cradle08/LLD_TMC/ReadMe.txt

LLD002_TMC5130_HAL：是液面探测TMC5130版本，裸机版本（采用HAL库，自己重新重构，已单独建库）
使用：MK文件下的工程

LLD002_TMC5130：是液面探测TMC5130版本，已该版本，采用rt-thread系统版本
使用：Project_debug文件下的工程

LLD001_FDC2212_DLVR_v3.0.0_TMC2209：添加了2209的驱动，没有算法
LLD002_TMC5130A - 20230410.rar：20230421美静发送过来的--需更新5130部分功能

/*************************液面探测驱动板*********************************/
STM32F103C8T6, 20k_RAM, 64_Flash

CAN:
    RX: PA11
    TX: PA12

UART:(链接TMC)
    UART_RX：PA10
    UART_TX：PA9

IIC1:(气压传感器)
    CLK:  PB6
    SDA: PB7

IIC2（电容传感器）:
    CLK:  PB10
    SDA: PB11

SYS_LED:
    PB4

SW1-4:
    PC13\PC14\PC15, PA7

NTC：
    PA3（ADC）

FDC2212: 
    ADD: PA1
    INTB: PA4
    SD: PA5

光耦：
P_DP1: PA15（复位光耦）
P_DP1: PB0（限位位光耦）

LLD液面探测反馈信号: 
    PB1

SPI2: (链接FLASH)
    SPI_MOSI: PB15
    SPI_MISO: PB14
    SPI_CLK: PB13
    SPI_CS: PB12

TMC5130:
    SPI_MOSI: PB15
    SPI_MISO: PB14
    SPI_CLK: PB13
    SPI_CS: PB3

TMC2209:
    SPREAD: PB3
    DIR: PB4
    EN: PA6
    STEP:PB5
    CLK:PA8
