cradle08/LLD_TMC/Doc/液面探测/CPLLD模块CAN通讯协议V1.0.0_20220525.docx

CPLLD模块Can通讯协议

1、 更改日志

日期 | 作者 | 版本 | 备注
2021-12-10 | Lmj | V1.0.0 | 首次草稿

# 1. 概述

本文编写了电容和气压液面探测模块与上位机通信的CAN协议，具体要求如下：

- 本协议用于自动化研发中心自制板卡CAN通讯。
- 板卡不能主动上传数据，采用查询的方式通讯，及主机发一条命令给模块，模块回且只回一条命令给主机。
- 主机发给模块，模块返回给主机的数据都由8个byte组成。
- 数据格式是小端格式。

# 2. CAN网络的设计

## 2.1 总线传输速率

CAN总线传输速率为1Mbit/s，标准帧。

## 2.2 终端电阻

无要求。

# 3. 报文设计

## 3.1 报文格式

报文格式说明如下：

Host to module:

Byte Index | 说明
CanID | Target address | 帧识别码

数据
Byte0 | Message ID | 报文编号
Byte1 | Instruction Numbe | 0：电机；1：蜂鸣器；2：照明灯；3：层流罩转速；4：IO；5：LED； 200：配置电容传感器（本项目特殊指令）； 201：配置气压传感器（本项目特殊指令）； 202：启用传感器指令（本项目特殊指令）； 203：探测液面结果（本项目特殊指令）； 204：预留（本项目特殊指令）； 205：预留（本项目特殊指令）； 206：预留（本项目特殊指令）； 207：设置电容探测参数1（本项目特殊指令）； 208：设置电容探测参数2（本项目特殊指令）； 209：设置电容探测参数3（本项目特殊指令）； 210：读电容映射数据（本项目特殊指令）； 211：设置气压探测参数1（本项目特殊指令）； 212：设置气压探测参数2（本项目特殊指令）； 213：设置气压探测参数3（本项目特殊指令）； 214：读气压映射数据； 215：设置气压探测参数4（本项目特殊指令）； 216：设置气压探测参数5（本项目特殊指令）； 253：读固件程序名称； 254：读固件程序版本；
Byte2 | 参数ID | 0：读操作；1：写操作。
Byte3 | 设备ID | 设备编号。以电机为例，0表示0#电机，1表示1#电机，以此类推。蜂鸣器、照明灯等同理。
Byte4 | Operand Byte3 | 设置值
Byte5 | Operand Byte2 | 设置值
Byte6 | Operand Byte1 | 设置值
Byte7 | Operand Byte0 | 设置值

Module reply：

Byte Index | 说明
CanID | Reply address | 帧识别码

数据
Byte0 | Message ID | 同主机报文Message ID
Byte1 | Instruction Numbe | 同主机的Instruction Numbe
Byte2 | Status | 异常码
Byte3 | Operand Byte4 | 应答值
Byte4 | Operand Byte3 | 应答值
Byte5 | Operand Byte2 | 应答值
Byte6 | Operand Byte1 | 应答值
Byte7 | Operand Byte0 | 应答值

上位机发送报文示意图。

## 3.2 异常码

Status：如果正常则返回100，异常作为错误代码。

Code | Meaning
0 | Successfully executed, no error
1 | Instruction not available
2 | Operation error
3
….

# 4. 应用报文协议

主机与模块的报文如下：

（1）Host to module：读端口状态

Byte Index | 说明
CanID | Target address | 201-208

数据
位置 | | | 备注
Byte0 | Message ID | 消息ID | 上位机设定
Byte1 | Instruction Numbe | 4
Byte2 | Operation | 0x00：读 | 读操作。
Byte3 | Operand Byte4 | 0 | 数值表示IO编号，0表示0#的IO，1表示1#的IO，以此类推。
Byte4 | Operand Byte3 | 0x00
Byte5 | Operand Byte2 | 0x00
Byte6 | Operand Byte1 | 0x00
Byte7 | Operand Byte0 | 0x00

Module reply：

Byte Index | 说明
CanID | Reply address | 同Target address

数据
位置 | 字节含义 | 数值 | 备注
Byte0 | Message ID | 同主机Message ID
Byte1 | Instruction Numbe | 同主机Instruction Numbe
Byte2 | Status | 0：无故障；1：指令错误；2：操作错误； | 异常码。
Byte3
Byte4
Byte5
Byte6
Byte7 | IO状态 | 0x00：低电平； 0x01：高电平。

（2）Host to module：查询/配置电容传感器寄存器。

Byte Index | 说明
CanID | Target address | 201-208

数据
位置 | 字节含义 | 数据 | 备注
Byte0 | Message ID | 消息ID | 上位机设定
Byte1 | Instruction Numbe | 200
Byte2 | Operation | 0x00：读；0x01：写。 | 读写操作。
Byte3 | Operand Byte4 | 0x00 | 预留
Byte4 | Operand Byte3 | 0x00 | 预留
Byte5 | Operand Byte2 | 0x00 | 预留
Byte6 | Operand Byte1 | 0x00 | 预留
Byte7 | Operand Byte0 | 0x00 | 预留

Module reply：模块应答。

Byte Index | 说明
CanID | Reply address | 同Target address

数据
位置 | 字节含义 | 数据 | 备注
Byte0 | Message ID | 同主机Message ID
Byte1 | Instruction Numbe | 同主机Instruction Numbe
Byte2 | Status | 0：无故障；1：指令错误；2：操作错误； | 异常码。
Byte3 | Operand Byte4 | 0x00 | 预留
Byte4 | Operand Byte3 | 0x00 | 预留
Byte5 | Operand Byte2 | 0x00 | 预留
Byte6 | Operand Byte1 | 0x00 | 预留
Byte7 | Operand Byte0 | 0x00 | 预留

（3）Host to module：查询/配置气压传感器。

Byte Index | 说明
CanID | Target address | 201-208

数据
位置 | 字节含义 | 数值 | 备注
Byte0 | Message ID | 消息ID | 上位机设定
Byte1 | Instruction Numbe | 201
Byte2 | Operation | 0x00：读；0x01：写。 | 读写操作。
Byte3 | Operand Byte4 | 0x00 | 预留
Byte4 | Operand Byte3 | 0x00 | 预留
Byte5 | Operand Byte2 | 0x00 | 预留
Byte6 | Operand Byte1 | 0x00 | 预留
Byte7 | Operand Byte0 | 0x00 | 预留

Module reply：模块应答。

Byte Index | 说明
CanID | Reply address | 同Target address

数据
位置 | 字节含义 | 数据名 | 备注
Byte0 | Message ID | 同主机Message ID
Byte1 | Instruction Numbe | 同主机Instruction Numbe
Byte2 | Status | 0：无故障；1：指令错误；2：操作错误； | 异常码。
Byte3 | Operand Byte4 | 0x00 | 预留
Byte4 | Operand Byte3 | 0x00 | 预留
Byte5 | Operand Byte2 | 0x00 | 预留
Byte6 | Operand Byte1 | 0x00 | 预留
Byte7 | Operand Byte0 | 0x00 | 预留

（4）Host to module：启用传感器。

Byte Index | 说明
CanID | Target address | 201-208

数据
位置 | | | 备注
Byte0 | Message ID | 消息ID | 上位机设定
Byte1 | Instruction Numbe | 202
Byte2 | Operation | 0x00：读；0x01：写。 | 读写操作。
Byte3 | Operand Byte4 | 0x00
Byte4 | Operand Byte3 | 0x00
Byte5 | Operand Byte2 | 0x00
Byte6 | Operand Byte1 | 0x00
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
Byte0 | Message ID | 同主机Message ID
Byte1 | Instruction Numbe | 同主机Instruction Numbe
Byte2 | Status | 0：无故障；1：指令错误；2：操作错误； | 异常码。
Byte3 | Operand Byte4 | 0x00 | 预留。
Byte4 | Operand Byte3 | 0x00 | 预留。
Byte5 | Operand Byte2 | | 参数编号
Byte6 | Operand Byte1 | 0-65535 | 参数值
Byte7 | Operand Byte0
