cradle08/LLD_TMC/Doc/PCB/055-000275-00 S8液面探测电机驱动原理图 A版本_TMC2209.pdf

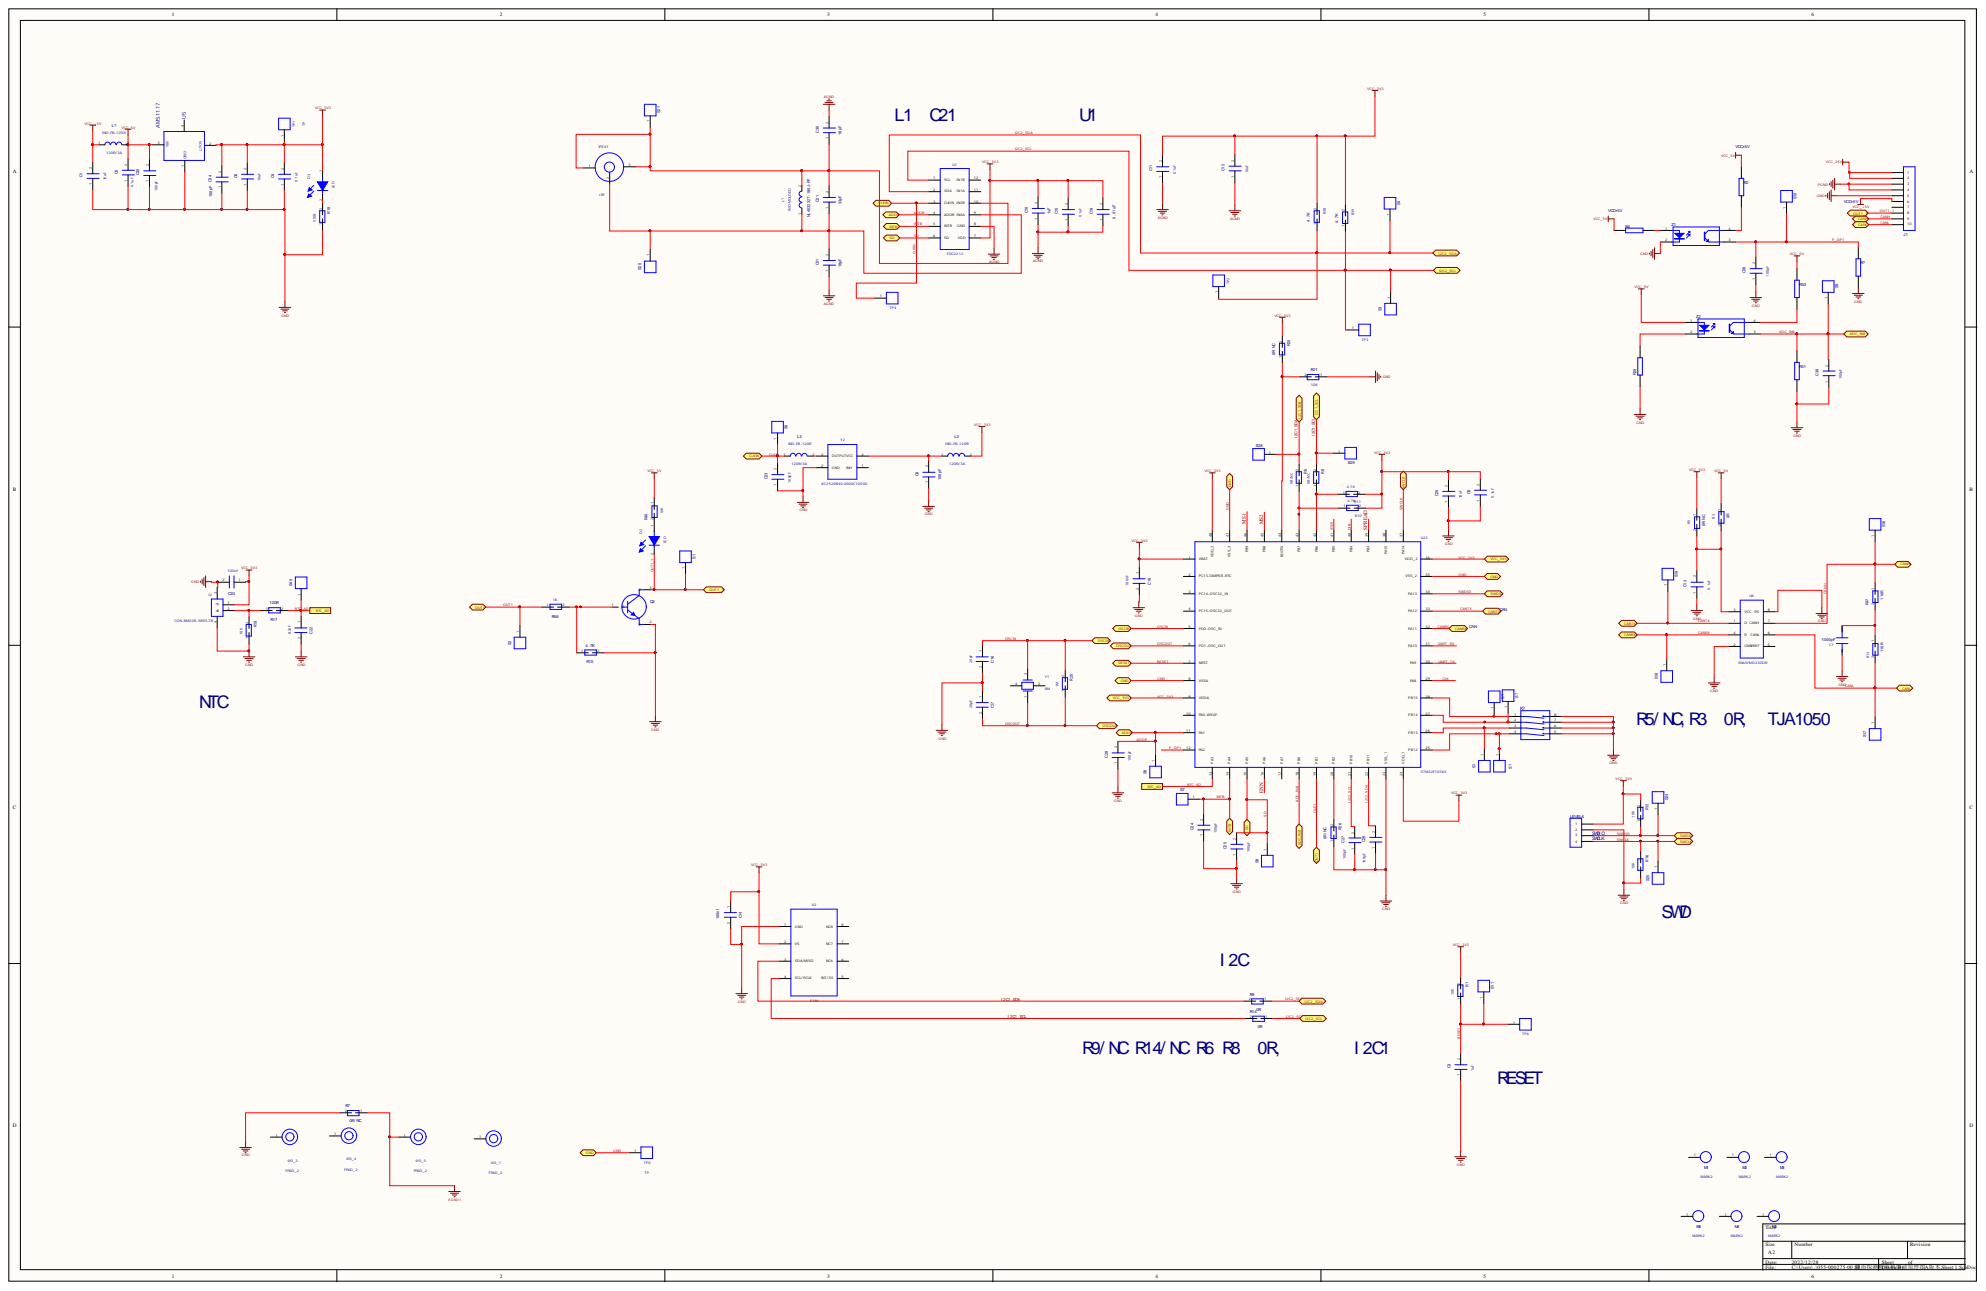
[picture p11: page 1]

SWDI O S SWCL K S | W D W C L K

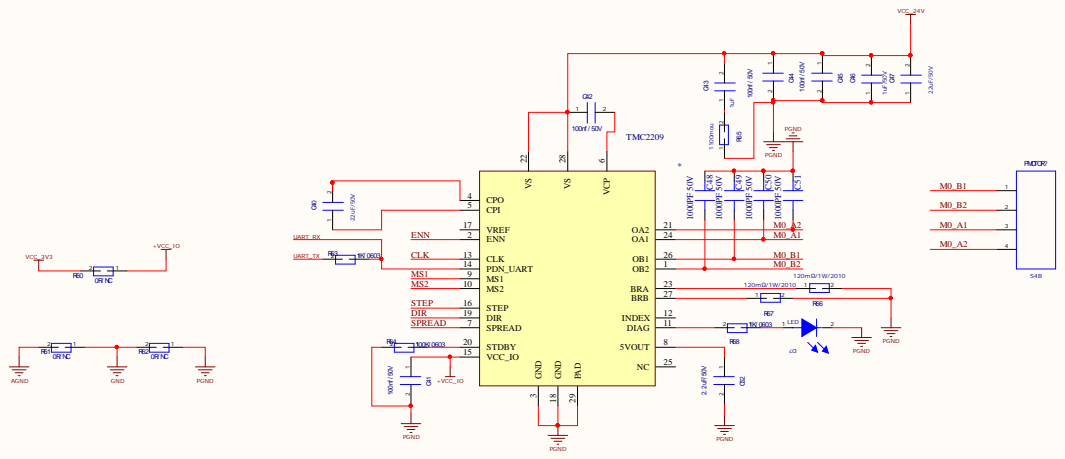
[picture p12: page 2]

PGN

Comment | Description | Designator | Footprint | LibRef | Quantity
TMC2209 | | | | TMC2209 | 1
FPAD_2 | | @0_1,@0_3,@0_4,@FPAD_2 | | FPAD_2 | 4
C0603 | | C1, C3, C4, C5, C6, C8C0603 | | 0603 | 38
CAP0603 | SURFACE MOUNT CAPC7 | | 0603 | CAP0603 | 1
C0603 | | C13 | AK-0603-R | C0603 | 1
C0603 22nf | | C40,C46,C47 | AK-0603-R | C0603 | 3
CAP 100PF50VC0402CAP X7R 100PF 50V J C48,C49,C50,C51 | | | C0402 | CAP 100PF50VC0402 | 4
LED | LIGHT EMITTING DIODD2, D3, D? | | LED0805 | LED | 3
JRF | | IPEX1 | RF4G | JRF | 1
BGI-CON10 | | J1 | BGI-1.27-10-FFC | BGI-CON10 | 1
CON-BM02B-SRSS-TB | | J2 | BM02B-SRSS-TB | CON-BM02B-SRSS-TB | 1
FNVE-04T | | K? | FNVE-04T | FNVE-04T | 1
IND-MOLDED | MOLDED INDUCTOR, L1 | | 322522 | IND-MOLDED | 1
IND-FB-120R | IND FB 120R@100M 3L2 ,L3, L? | | L0805 | IND-FB-120R | 3
AK-CON4 | Connector THT | LEVEL6 | BGI-2.0-4 | AK-CON4 | 1
MARK2 | | M1, M2, M3, M4, M5, MMARK2 | | MARK2 | 6
S4B | | PMOTOR? | CON_S4B-PH-K-S | S4B | 1
MMBT8050 | SS8050 | Q2 | SOT23 | MMBT8050 | 1
R0603 | | R1, R3, R5, R6, R7, R8R0603 | | 0603 | 35
AK-RES | Resister | R2, R4, R28, R30, R31AK-0603-R | | AK-RES | 6
TP | | S1, S2, S3, S4, S5, S6TP-1 D5M-RAD | | TP | 3 2
FDC2212 | | U1 | WSON-12 | FDC2212 | 1
E1NJ | | U2 | PAD-10 | E1NJ | 1
AMS1117 | | U5 | SOT223 | AMS1117 | 1
SN65HVD230DR | | U6 | SOIC-8(8S1)_SN65HVSN65HVD230DR | | 1
STM32F103XX | | U23 | LQFP-48N | STM32F103XX | 1
XTAL2 | CRYSTAL WITH GND PY1 | | OSCCC250X320X75-4NXTAL2 | | 1
KC2520B40.0000C10E00 | | Y2 | KC2520B40.0000C10EKC2520B40.0000C10E | | 1
AK-TLP521 | TLP521 | Z1, Z2 | BGI-EE-SX1320 | AK-TLP521 | 2
