cradle08/LLD_TMC/Doc/TMC/TMC2209/MKS TMC2209 V2.0/MKS TMC2209 V2.0_001 SCH.pdf

## GND

+5V | GND +5V GND

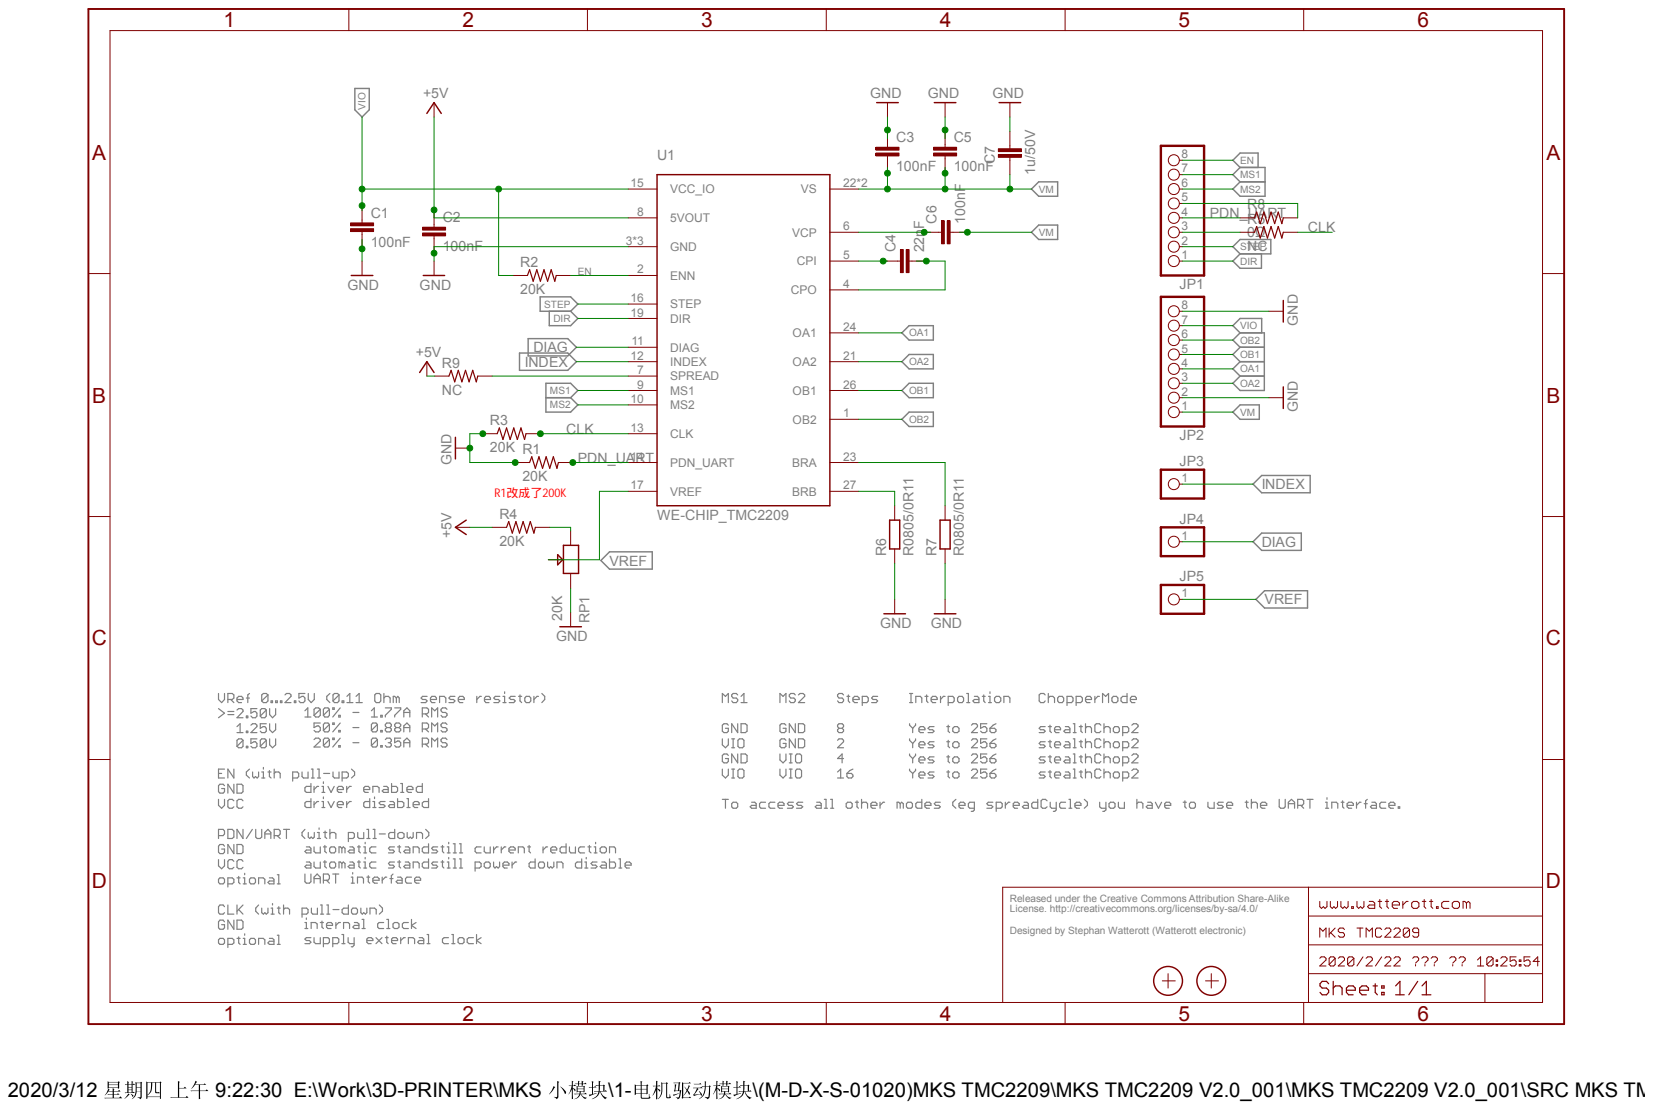
[picture p13: page 1]

Released under the Creative Commons Attribution Share-Alike
License. http://creativecommons.org/licenses/by-sa/4.0/

Designed by Stephan Watterott (Watterott electronic)
