cradle08/LLD_TMC/Doc/PCB/MGI LLD Board V6.0.0.pdf

# 电容式

电源

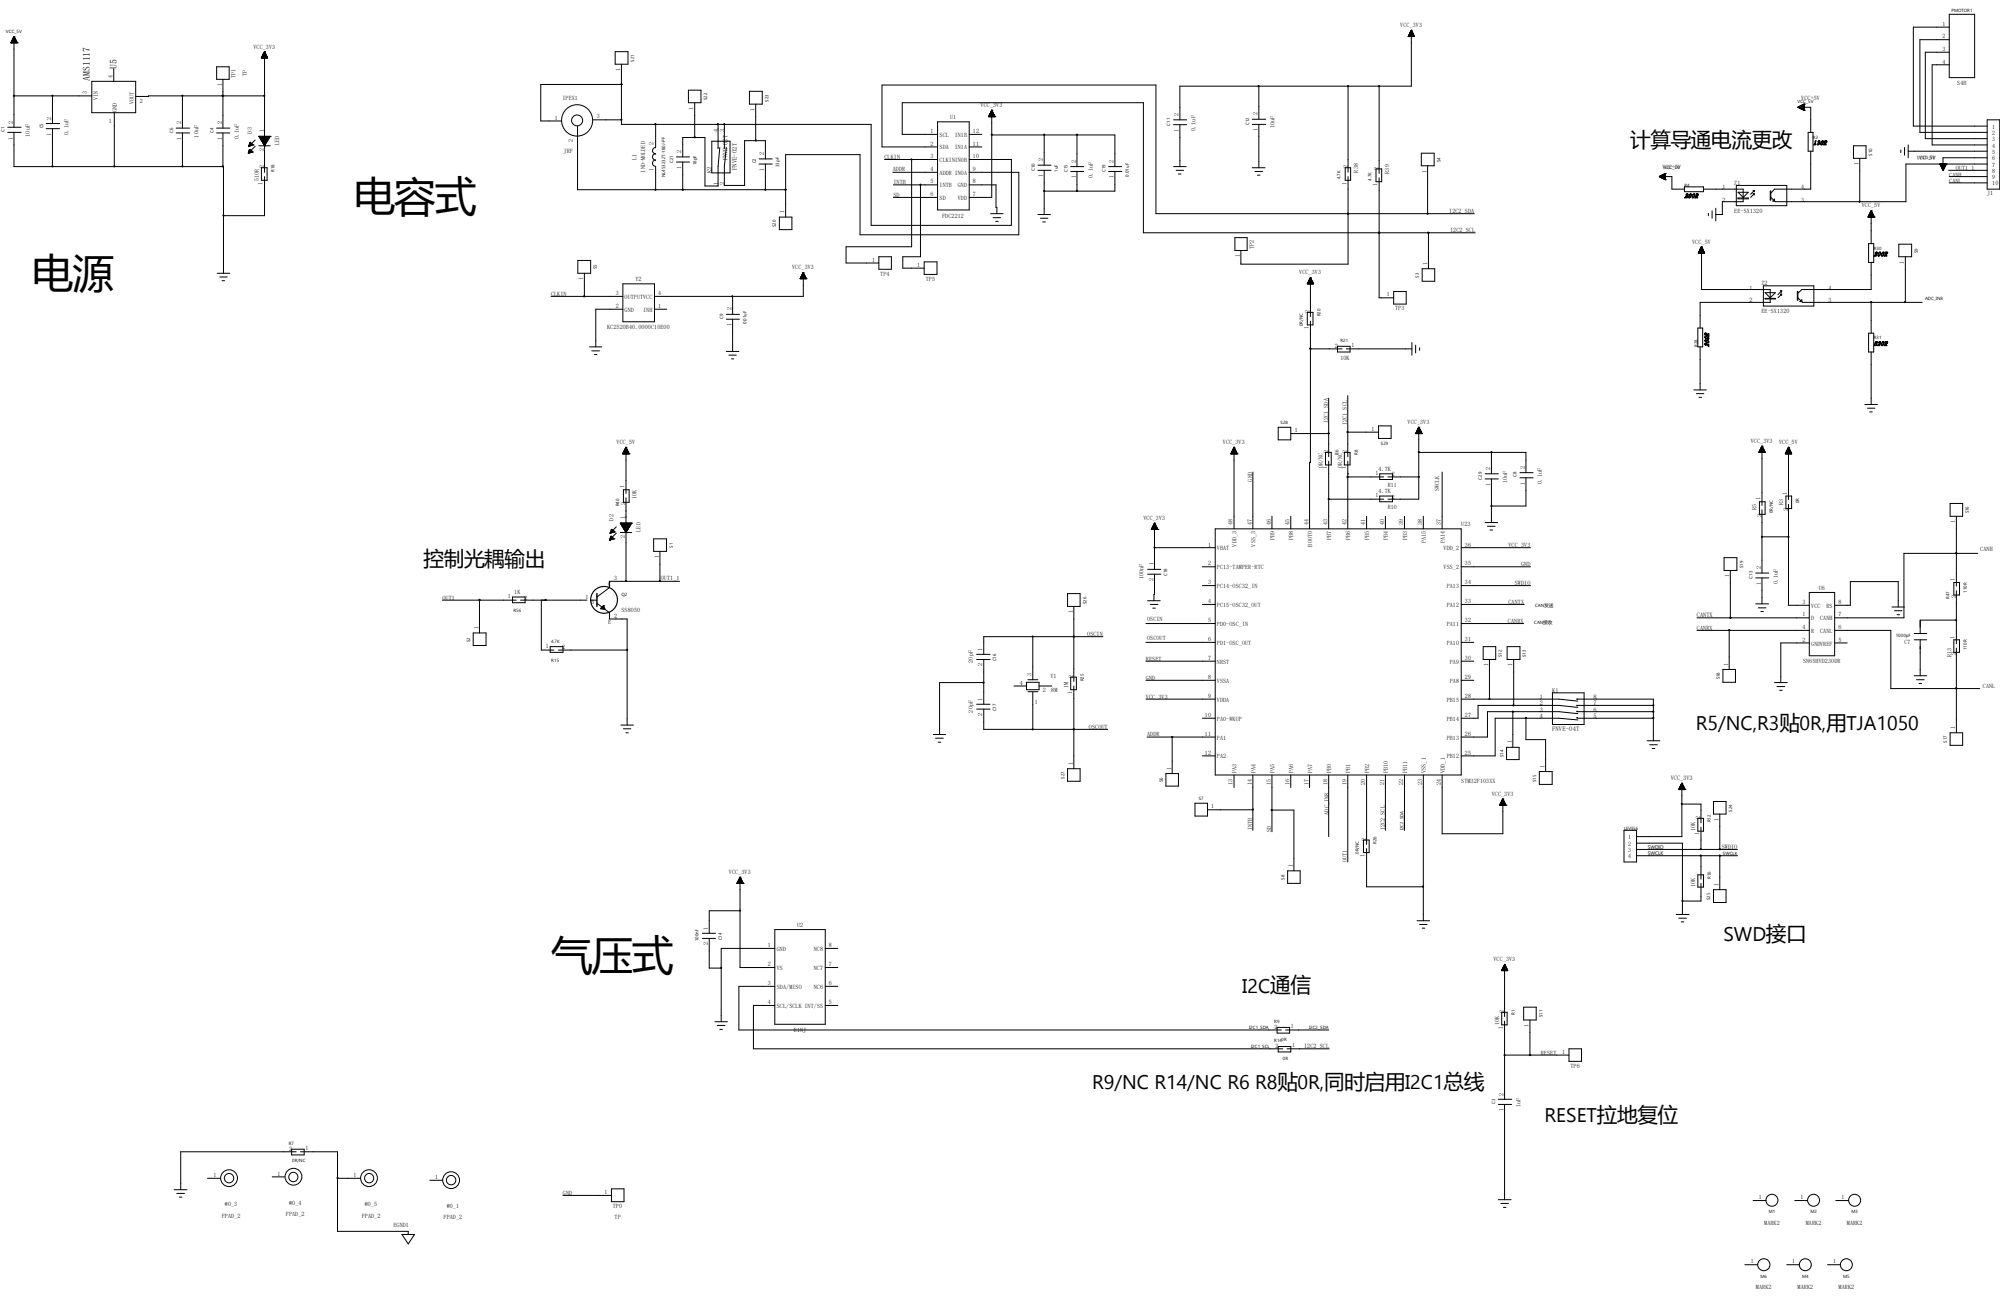
[picture p14: page 1]

SWCLK SWDIO
