cradle08/LLD_TMC/LLD002_TMC5130/Code/App/app.c

/*****************************************************************************
Copyright  : BGI
File name  : app.c
Description: 定义函数。
             注意线程中调用的子函数不能带有返回值！！！
Author     : lmj
Version    : 0.0.1
Date       : 完成日期
History    : 修 改 历 史 记 录 列 表 ， 每 条 修 改 记 录 应 包 括 修 改 日 期 、 修 改
者及修改内容简述。
*****************************************************************************/
#include "stm32f10x.h"
#include "include.h"


#include "event.h"
#include "eeprom.h"
#include "bsp_gpio.h"
#include "bsp_can.h"
#include "TMC_Api.h"
#include "process.h"
#include "log.h"
#include "project.h"
#include "TMC_Process.h"
#include "param.h"
#include "lld_param.h"



/*** 电机部分版本号 ***/
uint16_t g_usSoftVersion    = 0x0103;    //软件版本号
uint16_t g_usHardWareVesion = 0x0010;    //硬件版本号


//定义变量---------------------------------------------------------------------//
/*
 * @function: LLD_App
 * @details : 探测线程
 * @input   : parameter:参数，未使用。
 * @output  : NULL
 * @return  : NULL
 */
void LLD_App(void* parameter)
{
	while(1)
	{
		//同时使用IIC1和IIC2接口进行通信，发现有相互干扰现象。
		CapSensor();
		AirSensor();
		LLDReslut();
		
		rt_thread_delay(SoftSys.LLDPeriod);
	}
}






void EPPROM_Data_Reset(void)
{
	extern __IO GlobalParam_t g_tGlobalParam;
	extern __IO Process_t g_tProcess;
	extern __IO AxisParamDefault_t g_tAxisParamDefault;
	
	
	//第一次上电, 初始化，保存
	Global_Param_SetDefault_Value(&g_tGlobalParam);
	//保存
	Save_Global_Param(&g_tGlobalParam);


	Axis_Param_Fixed_SetDefault_Value(&g_tAxisParamDefault);
	//保存轴参数
	Save_Axis_Param_Default(&g_tAxisParamDefault);

	Process_Param_SetDefault_Value(&g_tProcess);
	//保存轴参数
	Save_Process(&g_tProcess);
	
	//
	ClearAndSave_Default_LLDParams();
}



//电机运用初始化
//uint32_t ulTemp = 0;
void Motor_App_Init(void)
{
	uint32_t ulTemp = 0;
	extern __IO GlobalParam_t g_tGlobalParam;
	extern __IO Process_t g_tProcess;
	extern __IO BoardStatus_t g_tBoardStatus;
	
	LED_Shine(4, 60);
	
	ulTemp = sizeof(LLDParam_t);            //0x0B=11
	ulTemp = sizeof(GlobalParam_t);         //0x291=657
	ulTemp = sizeof(AxisParamDefault_t);    //0x54=84
	ulTemp = sizeof(Process_t);             //0x8FA=2298
	

	//全局值初始化
	Global_Status_Init();

	//获取、打印识别码信息
	Get_SN(1);
//	g_tBoardStatus.usSN = Get_SN(1);

	//参数初始化
	EEPROM_Init();
	
	//液面探测参数
	if(ERROR_TYPE_EEPROM == LLDParam_Init())
	{  
		//读取数据异常
		g_tBoardStatus.ucEEPRAM_Init_CRC_ErrFlag = 1;
	}
	
	//全局参数
	if(ERROR_TYPE_EEPROM == Global_Param_Init())
	{  
		//读取数据异常
		g_tBoardStatus.ucEEPRAM_Init_CRC_ErrFlag = 1;
	}
//	EPPROM_Data_Reset();
//	LOG_Info("Can: Baud=%d, RecvID=%d, SendID=%d", g_tGlobalParam.eCanBaud, g_tGlobalParam.ulRecvCanID, g_tGlobalParam.ulSendCanID);

	//默认轴参数
	//1.不加中断，读取电机参数被中断打断，数据混乱，TMC5130A的MOS管烧毁。
	//2.加中断，程序卡死，与调用rt_thread_mdelay函数有关。
//	__disable_irq();   
	if(ERROR_TYPE_EEPROM == Axis_Param_Default_Init())
	{
		//读取数据异常
		g_tBoardStatus.ucEEPRAM_Init_CRC_ErrFlag = 1;
	}
//	__enable_irq(); 
	
	//EPPROM_Data_Reset(); 
	//Can初始化,ID
	//Bsp_Can_Init(g_tGlobalParam.eCanBaud);
	CAN_MonInit();

	//TMC
	TMC_Init();

	//流程初始化
	if(ERROR_TYPE_EEPROM == Process_Init())
	{
		//读取数据异常
		g_tBoardStatus.ucEEPRAM_Init_CRC_ErrFlag = 1;
	}

	//流程自动执行
	if(g_tGlobalParam.ucProcessAutoExecMode == 1)
	{
		//自动模式，自动执行
		g_tProcess.eProcessStatus = EN_PROCESS_STATUS_EXEC;
	}
}


/*
 * @function: CanMonitor
 * @details : 上位机Can监控
 * @input   : parameter:参数。未使用。
 * @output  : NULL
 * @return  : NULL
 */
//uint32_t lT = 0;
void CommMonitor(void* parameter)
{
//	uint32_t i = 0, Tick = 0;
	Motor_App_Init();
	
//	lT = TMC5160_ReadInt(TMC_0, TMC5160_GCONF);
//	TMC5160_WriteInt(TMC_0, TMC5160_IHOLD_IRUN, 0x00070903);
//	TMC5160_WriteInt(TMC_0, TMC5160_GCONF, 0x00000000 | 1<<4);
//	
//	lT = TMC5160_ReadInt(TMC_0, TMC5160_GCONF);
//	lT = TMC5160_ReadInt(TMC_0, TMC5160_CHOPCONF);
//	lT = TMC5160_ReadInt(TMC_0, TMC5160_PWMCONF);
//	
//	TMC_Rotate(TMC_0, 0, 12800);
	
	while(1)
	{
//		uint32_t ulTick = rt_tick_get();
		
//		BSP_UartCommStage(&ModbusMon.Usart);
		
		SWSysTimeTick.T10ms++;
		if(SWSysTimeTick.T10ms >= 5)
		{
			//示波器抓取运行时间17.40us
			SWSysTimeTick.T10ms = 0;
			
			
			IWDG_ReloadCounter();
			CheckPhotosensor();
//			DipSWCheck();
			TempNTC();   //执行时间较长，需要优化
		}
		
		
		SWSysTimeTick.T1s++;
		if(SWSysTimeTick.T1s >= 498)
		{
			SWSysTimeTick.T1s = 0;
			
			
			Accumulation16(&SWSysTimeTick.PowerOnS);
			Accumulation8(&CapSenPara.RdyTime);
			
			if(2 == SoftSys.MCUResetStatus)
			{
				MCU_Reset();
			}
			
			SYS_LED_TRIGGER;
		}
		
		
		
		CanMonComStage();
		
		//电机协议处理
		Event_Process();

		
//		//执行流程处理
//		Process_Handle(ulTick);
//		//电机复位处理
//		Motor_Reset_Handle(ulTick);
		
		
//		TMC2209_WriteInt(0x10,0x00070903); //IHOLD_IRUN: IHOLD=3, IRUN=0C=600MA电流, IHOLDDELAY=7
//		Tick = rt_tick_get();
//		while(i < Tick+5000)
//		{
//			TMC2209_STEP_HIGH;
//			Delay_US(10);
//			TMC2209_STEP_LOW;
//			Delay_US(10);
//			
//			i = rt_tick_get();
//		}
//		rt_thread_delay(5000);
		
		
//		//手动产生方波
//		//TMC2209_WriteInt(0x10,0x00070903); //IHOLD_IRUN: IHOLD=3, IRUN=0C=600MA电流, IHOLDDELAY=7
//		//TMC2209_WriteInt(0x10,0x00071403);
//		TMC2209_WriteInt(0x10,0x00070903); //0-31
//		Tick = rt_tick_get();
//		while(i < Tick+5000)
//		{
//			TMC2209_STEP_HIGH;
//			Delay_US(10);
//			TMC2209_STEP_LOW;
//			Delay_US(10);
//			
//			i = rt_tick_get();
//		}
////		rt_thread_delay(5000);
		
		
		
		rt_thread_delay(2);
	}
}


/*
 * @function: MotorDrive
 * @details : 电机驱动
 * @input   : parameter:参数。未使用。
 * @output  : NULL
 * @return  : NULL
 */
void MotorDrive(void* parameter)
{
	while(1)
	{
		uint32_t ulTick = rt_tick_get();
		
		
		//执行流程处理
		Process_Handle(ulTick);
		  
//		if(ulTick - s_ulTick >= 250)
//		{
//			//异常检测
//			Period_Error_Check(ulTick);
//		}
		
		//电机复位处理
		Motor_Reset_Handle(ulTick);
		
		
		rt_thread_delay(1);
	}
}
