cradle08/LLD_TMC/LLD002_TMC5130/Code/App/monitor_can.c

/*****************************************************************************
Copyright  : BGI
File name  : monitor.c
Description: 上位机监控
Author     : lmj
Version    : 0.0.0.1
Date       : 完成日期
History    : 修 改 历 史 记 录 列 表 ， 每 条 修 改 记 录 应 包 括 修 改 日 期 、 修 改
者及修改内容简述。
*****************************************************************************/
#include "monitor_can.h" 
#include "include.h"
#include "stdlib.h"
#include "time.h"

//
#include "event.h"
#include "param.h"

//定义变量---------------------------------------------------------------------//
struct tagMonCan    MonCan;




//定义函数---------------------------------------------------------------------//
/*
 * @function: QueueLoopPop
 * @details : 循环队列数据出栈
 * @input   : 1.queue：队列。
              2.des_buf：目的地缓存。
              3.type_len：数据类型。
 * @output  : NULL
 * @return  : 0：成功；1：缓存数据为空。
 */
uint16_t QueueLoopCanPop(struct tagQueueLoop *queue, uint8_t *des_buf)
{
	uint16_t   ret = 0;
	uint8_t    i = 0;
	
	
	if(queue->Rear == queue->Front)
	{
		ret = 1;
	}
	else
	{
		for(i = 0; i < CAN_QUEUE_LOOP_WIDTH; i++)
		{
			des_buf[i] = queue->Buf[(queue->Front * CAN_QUEUE_LOOP_WIDTH) + i];
		}
		
		queue->Front++;
		queue->Front = queue->Front % queue->Len;
	}
	
	
	return (ret);
}

/*
 * @function: QueueLoopInsert
 * @details : 循环队列插入数据
 * @input   : 1.queue：监控管理指针。
              2.src_data：源数据。
 * @output  : NULL
 * @return  : 0：成功；其他：故障指令。
 */
uint16_t QueueLoopCanInsert(struct tagQueueLoop *queue, uint8_t *src_data)
{
	uint16_t   ret = 0;
	uint16_t   temp = 0;
	uint8_t    i = 0;
	
	
	temp = QueueLoopIsFull(queue);
	if(temp)
	{
		ret = 1;
	}
	else
	{
		for(i = 0; i < CAN_QUEUE_LOOP_WIDTH; i++)
		{
			queue->Buf[(queue->Rear * CAN_QUEUE_LOOP_WIDTH) + i] = src_data[i];
		}
		
		queue->Rear++;
		queue->Rear = queue->Rear % queue->Len;
	}
	
	
	return (ret);
}





/*
 * @function: CAN_ParaInit
 * @details : Can初始化参数
 * @input   : NULL
 * @output  : NULL
 * @return  : NULL
 */
void CAN_ParaInit(void)
{
	QueueLoopInit(&MonCan.RxQueue, MonCan.RxBuf, CAN_QUEUE_LOOP_LEN);
//	QueueLoopInit(&MonCan.RxBroadCastQueue, MonCan.RxBroadCastBuf, CAN_QUEUE_LOOP_LEN);
}


///*
// * @function: CAN_MonInit
// * @details : Can监控初始化
// * @input   : NULL
// * @output  : NULL
// * @return  : NULL
// */
//uint8_t CAN_MonInit(void)
//{
//	extern __IO GlobalParam_t g_tGlobalParam; 
//	uint8_t     ret = FALSE;
//	uint16_t    can_id = 0, can_id_motor = 0;
//	uint8_t     bps = 0;
//	uint8_t     offset = 0;
//	
//	
//	
//	//寻找Can通信故障的原因，实测仍然出现通信故障。
////	if(SWSysTimeTick.PowerOnS >= 5)
////	{
////		return (ret);
////	}
//	
//	//设置Can ID
//	offset = SoftSys.DipSW[0] & 0x07;
//	can_id = CAN_ID_MIM + offset;
//	if((can_id < CAN_ID_MIM) || (can_id > CAN_ID_MAX))
//	{
//		//默认通信地址
//		can_id = CAN_ID_MIM;
//	}
//	
//	//设置Can波特率模式
//	offset = SoftSys.DipSW[0] & 0x08;
//	if(0x00 == offset)
//	{
//		bps = CAN_BPS_MODE_1M;
//	}
//	else if(0x08 == offset)
//	{
//		bps = CAN_BPS_MODE_500K;
//	}
//	
//	
//	if((can_id != MonCan.Confg.ModuleID) || (bps != MonCan.Confg.BpsMode))
//	{
//		CAN_ITConfig(CAN1, CAN_IT_FMP0, DISABLE);
//		
//		CAN_ParaInit();
//		QueueLoopClear(&MonCan.RxQueue);
//		
//		MonCan.Confg.BpsMode = bps;
//		MonCan.Confg.ModuleID = can_id;
//		MonCan.Confg.BroadcastID = 0x7FE;
//		Init_RxMes(&MonCan.RxMsg);
//		
//		CAN_GPIO_Config();
//		CAN_Config(CAN1, &MonCan.Confg);
//		CAN_NVIC_Config();
//	}
//	return ret;
//}


/*
 * @function: CAN_MonInit
 * @details : Can监控初始化
 * @input   : NULL
 * @output  : NULL
 * @return  : NULL
 */
uint8_t CAN_MonInit(void)
{
	extern __IO GlobalParam_t g_tGlobalParam; 
	uint8_t     ret = FALSE;
//	uint16_t    can_id = 0, can_id_motor = 0;
//	uint8_t     bps = 0;
//	uint8_t     offset = 0;

	CAN_ITConfig(CAN1, CAN_IT_FMP0, DISABLE);
	
	CAN_ParaInit();
	QueueLoopClear(&MonCan.RxQueue);
	Init_RxMes(&MonCan.RxMsg);
	
	CAN_NVIC_Config();
	CAN_GPIO_Config();
	CAN_Config(CAN1);
	
	
	return ret;
}


//uint8_t CAN_MonInit(void)
//{
//	uint8_t     ret = FALSE;
//	
//	
//	CAN_ParaInit();
//	QueueLoopClear(&MonCan.RxQueue);
//	
//	MonCan.Confg.BpsMode = CAN_BPS_MODE_1M;
//	MonCan.Confg.ModuleID = 201;
//	MonCan.Confg.BroadcastID = 0x7FE;
//	Init_RxMes(&MonCan.RxMsg);
//	
//	CAN_NVIC_Config();
//	CAN_GPIO_Config();
//	CAN_Config(CAN1, &MonCan.Confg);
//	
//	
//	return ret;
//}



/*
 * @function: CanIRQRecv
 * @details : 接收报文。
 * @input   : NULL
 * @output  : NULL
 * @return  : 接收报文的结果，0：失败；1：成功。
 */
uint8_t CanIRQRecv(void)
{
	extern __IO LLDParam_t       g_tLLDParam;
	extern __IO GlobalParam_t    g_tGlobalParam;
	uint8_t     ret = FALSE;
	uint16_t    result = FALSE;
	CanRxMsg    rx_msg;
	
	
	//从邮箱中读出报文
	CAN_Receive(CAN1, CAN_FIFO0, &rx_msg);
	
	//比较ID
	if((rx_msg.StdId == g_tLLDParam.CanConfig.ModuleID) && (CAN_ID_STD == rx_msg.IDE) && (8 == rx_msg.DLC))
	{
		//接收成功
		MonCan.ReceFinish = TRUE;
		
		//使用Can接收队列。
		result = QueueLoopCanInsert(&MonCan.RxQueue, rx_msg.Data);
	}
//	else if((rx_msg.StdId == CAN_BROADCAST_ID_LLD) && (CAN_ID_STD == rx_msg.IDE) && (8 == rx_msg.DLC))
//	{
//		//接收成功
//		MonCan.ReceBroadcastFinish = TRUE;	
//		
//		//使用Can接收队列。
//		result = QueueLoopCanInsert(&MonCan.RxBroadCastQueue, rx_msg.Data);
//	}
	else if(((rx_msg.StdId == g_tGlobalParam.ulRecvCanID) || (rx_msg.StdId == CAN_BROADCAST_ID_MOTOR)) && (CAN_ID_STD == rx_msg.IDE) && (8 == rx_msg.DLC))
	{
		//接收成功
		SysEvent_t *ptSysEvent = NULL;
		ptSysEvent = SysEventAlloc();
		if(NULL != ptSysEvent)
		{
			ptSysEvent->eMsgType = MSG_TYPE_CAN;
			
			memmove((void*)ptSysEvent->tMsg.tMsgCan.ucaBuffer, (void*)rx_msg.Data, CAN_MSG_DATA_LENGTH);
			
			ptSysEvent->tMsg.tMsgCan.ulRecvCanID = rx_msg.StdId;
			SysEventPut(ptSysEvent, 0);
		}
	}
	
	
	return ret;
}












/*
 * @function: MonOperateIOReply
 * @details : 应答上位机读写IO。
 * @input   : 1.mon：管理指针。
              2.buff：缓存。
 * @output  : NULL
 * @return  : 应答状态。
 */
uint8_t MonOperateIOReply(struct tagMonCan *mon, uint8_t *buff)
{
	uint8_t    ret = CAN_OPE_REPLY;
	
	
	LLDMonReadIO(buff, 0);
	
	
	return (ret);
}


/*
 * @function: MonTempReply
 * @details : 应答上位机读温度。
 * @input   : 1.mon：管理指针。
              2.buff：缓存。
 * @output  : NULL
 * @return  : 应答状态。
 */
uint8_t MonTempReply(struct tagMonCan *mon, uint8_t *buff)
{
	uint8_t    ret = CAN_OPE_REPLY;
	
	
	ReadTemp(buff, mon->CanMess.DevNo);
	
	
	return(ret);
}




/*
 * @function: MonReadSoftHardVerReply
 * @details : 应答读软件硬件版本。
 * @input   : 1.mon：管理指针。
              2.buff：缓存。
 * @output  : NULL
 * @return  : 应答状态。
 */
uint8_t MonReadSoftHardVerReply(struct tagMonCan *mon, uint8_t *buff)
{
	uint8_t    ret = CAN_OPE_REPLY;
	
	
	ReadSoftHardWareVer(buff, mon->CanMess.DevNo);
	
	
	return(ret);
}


/*
 * @function: MonResetMCU
 * @details : 重置MCU。
 * @input   : 1.mon：管理指针。
              2.buff：缓存。
 * @output  : NULL
 * @return  : 应答状态。
 */
uint8_t MonResetMCU(struct tagMonCan *mon, uint8_t err)
{
	uint8_t    ret = 0;
	
	
	//故障指令或操作码，不进行任何操作
	if(ERR_CAN_NULL != err)
	{
		return (err);
	}
	
	
	if((0 == mon->RxMsg.Data[1])
		|| (0 == mon->RxMsg.Data[4])
		|| (0 == mon->RxMsg.Data[5])
		|| (0 == mon->RxMsg.Data[6])
		|| (0 == mon->RxMsg.Data[7]))
	{
		SoftSys.MCUResetStatus = 1;
	}
	
	
	
	return (ret);
}

/*
 * @function: MonResetMCUReply
 * @details : 应答重置MCU。
 * @input   : 1.mon：管理指针。
              2.buff：缓存。
 * @output  : NULL
 * @return  : 应答状态。
 */
uint8_t MonResetMCUReply(struct tagMonCan *mon, uint8_t *buff)
{
	uint8_t    ret = CAN_OPE_REPLY;
	
	
	buff[4] = 0;
	buff[5] = 0;
	buff[6] = 0;
	buff[7] = 0;
	
	if(1 == SoftSys.MCUResetStatus)
	{
		SoftSys.MCUResetStatus = 2;
	}
	
	return(ret);
}



/*
 * @function: MonConfigAirSen
 * @details : 上位机配置气压式传感器参数。
 * @input   : 1.mon：监控管理指针。
              2.err：故障信息。
 * @output  : NULL
 * @return  : 0：成功；其他：故障指令。
 */
uint8_t MonConfigAirSen(struct tagMonCan *mon, uint8_t err)
{
	uint8_t    ret = 0;
	
	
	//故障指令或操作码，不进行任何操作
	if(ERR_CAN_NULL != err)
	{
		return (err);
	}
	
	//上位机写操作
	if(OPE_WRITE == mon->CanMess.CMDPara)
	{
	}
	
	
	return (ret);
}

/*
 * @function: MonConfigAirSenReply
 * @details : 应答上位机读写气压传感器配置。
 * @input   : 1.mon：管理指针。
              2.buff：缓存。
 * @output  : NULL
 * @return  : 应答状态。
 */
uint8_t MonConfigAirSenReply(struct tagMonCan *mon, uint8_t *buff)
{
	uint8_t    ret = CAN_OPE_REPLY;
	
	
	ReadAirSenReg(buff, 0);
	
	
	return(ret);
}


/*
 * @function: MonSelectSen
 * @details : 上位机启用传感器参数。
 * @input   : 1.mon：监控管理指针。
              2.err：故障信息。
 * @output  : NULL
 * @return  : 0：成功；其他：故障指令。
 */
uint8_t MonSelectSen(struct tagMonCan *mon, uint8_t err)
{
	uint8_t    ret = 0;
	
	
	
	//故障指令或操作码，不进行任何操作
	if(ERR_CAN_NULL != err)
	{
		return (err);
	}
	
	//上位机写操作
	if(OPE_WRITE == mon->CanMess.CMDPara)
	{
		//赋值操作	
		WriteSeleSen(mon->RxMsg.Data, 0);
	}
	
	
	return (ret);
}

/*
 * @function: MonSelectSen
 * @details : 应答上位机读取启用传感器。
 * @input   : 1.mon：管理指针。
              2.buff：缓存。
 * @output  : NULL
 * @return  : 应答状态。
 */
uint8_t MonSelectSenReply(struct tagMonCan *mon, uint8_t *buff)
{
	uint8_t    ret = CAN_OPE_REPLY;
	
	
	ReadSelectSen(buff, 0);
	
	
	return(ret);
}


/*
 * @function: MonReadLLD
 * @details : 上位机读液面探测数据。
 * @input   : 1.mon：监控管理指针。
              2.err：故障信息。
 * @output  : NULL
 * @return  : 0：成功；其他：故障指令。
 */
uint8_t MonReadLLD(struct tagMonCan *mon, uint8_t err)
{
	uint8_t    ret = 0;
	
	
	//故障指令或操作码，不进行任何操作
	if(ERR_CAN_NULL != err)
	{
		return (err);
	}
	
	//上位机写操作
	if(OPE_WRITE == mon->CanMess.CMDPara)
	{	
	}	
	
	
	return (ret);
}

/*
 * @function: MonReadLLDReply
 * @details : 应答上位机读液面探测数据。
 * @input   : 1.mon：管理指针。
              2.buff：缓存。
 * @output  : NULL
 * @return  : 应答状态。
 */
uint8_t MonReadLLDReply(struct tagMonCan *mon, uint8_t *buff)
{
	uint8_t    ret = CAN_OPE_REPLY;
	
	
	//阻塞应答
//	if(TRUE == AirSenPara.CommAckIsBlock)
//	{
//		return (CAN_OPE_WAIT);
//	}

	
	ReadLLDResult(buff, 0);
	
	
	return(ret);
}


/*
 * @function: MonRead204
 * @details : 预留
 * @input   : 1.mon：监控管理指针。
              2.err：故障信息。
 * @output  : NULL
 * @return  : 0：成功；其他：故障指令。
 */
uint8_t MonRead204(struct tagMonCan *mon, uint8_t err)
{
	uint8_t    ret = 0;
	
	
	//故障指令或操作码，不进行任何操作
	if(ERR_CAN_NULL != err)
	{
		return (err);
	}

	//上位机写操作
	if(OPE_WRITE == mon->CanMess.CMDPara)
	{	
	}	
	
	
	return (ret);	
}

/*
 * @function: MonRead204Reply
 * @details : 
 * @input   : 1.mon：管理指针。
              2.buff：缓存。
 * @output  : NULL
 * @return  : 应答状态。
 */
uint8_t MonRead204Reply(struct tagMonCan *mon, uint8_t *buff)
{
	uint8_t    ret = CAN_OPE_REPLY;
	
	
	return(ret);
}


/*
 * @function: MonRead205
 * @details : 上位机读电容数据
 * @input   : 1.mon：监控管理指针。
              2.err：故障信息。
 * @output  : NULL
 * @return  : 0：成功；其他：故障指令。
 */
uint8_t MonRead205(struct tagMonCan *mon, uint8_t err)
{
	uint8_t    ret = 0;
	
	
	//故障指令或操作码，不进行任何操作
	if(ERR_CAN_NULL != err)
	{
		return (err);
	}
	
	//上位机写操作
	if(OPE_WRITE == mon->CanMess.CMDPara)
	{	
	}
	
	
	return (ret);
}

/*
 * @function: MonRead205Reply
 * @details : 
 * @input   : 1.mon：管理指针。
              2.buff：缓存。
 * @output  : NULL
 * @return  : 应答状态。
 */
uint8_t MonRead205Reply(struct tagMonCan *mon, uint8_t *buff)
{
	uint8_t    ret = CAN_OPE_REPLY;
	
	
	
	return(ret);
}


/*
 * @function: MonRead206
 * @details : 预留
 * @input   : 1.mon：监控管理指针。
              2.err：故障信息。
 * @output  : NULL
 * @return  : 0：成功；其他：故障指令。
 */
uint8_t MonRead206(struct tagMonCan *mon, uint8_t err)
{
	uint8_t    ret = 0;
	
	
	//故障指令或操作码，不进行任何操作
	if(ERR_CAN_NULL != err)
	{
		return (err);
	}
	
	//上位机写操作
	if(OPE_WRITE == mon->CanMess.CMDPara)
	{
	}
	
	
	return (ret);
}

/*
 * @function: MonRead206Reply
 * @details : 
 * @input   : 1.mon：管理指针。
              2.buff：缓存。
 * @output  : NULL
 * @return  : 应答状态。
 */
uint8_t MonRead206Reply(struct tagMonCan *mon, uint8_t *buff)
{
	uint8_t    ret = CAN_OPE_REPLY;
	
	
	return(ret);
}


/*
 * @function: MonCapLLDPara1
 * @details : 上位机设置电容探测档位
 * @input   : 1.mon：监控管理指针。
              2.err：故障信息。
 * @output  : NULL
 * @return  : 0：成功；其他：故障指令。
 */
uint8_t MonCapLLDPara1(struct tagMonCan *mon, uint8_t err)
{
	uint8_t    ret = 0;
	
	
	//故障指令或操作码，不进行任何操作
	if(ERR_CAN_NULL != err)
	{
		return (err);
	}
	
	//上位机写操作
	if(OPE_WRITE == mon->CanMess.CMDPara)
	{
		//赋值操作
		WriteCLLDPara1(mon->RxMsg.Data, 0xFF);
	}
	
	
	return (ret);
}

/*
 * @function: MonCapLLDPara1Reply
 * @details : 应答上位机读设置电容探测灵敏度档位。
 * @input   : 1.mon：管理指针。
              2.buff：缓存。
 * @output  : NULL
 * @return  : 应答状态。
 */
uint8_t MonCapLLDPara1Reply(struct tagMonCan *mon, uint8_t *buff)
{
	uint8_t    ret = CAN_OPE_REPLY;
	
	
	ReadCLLDPara1(buff, 0);
	
	
	return(ret);
}


/*
 * @function: MonRead208
 * @details : 预留
 * @input   : 1.mon：监控管理指针。
              2.err：故障信息。
 * @output  : NULL
 * @return  : 0：成功；其他：故障指令。
 */
uint8_t MonRead208(struct tagMonCan *mon, uint8_t err)
{
	uint8_t    ret = 0;
	
	
	//故障指令或操作码，不进行任何操作
	if(ERR_CAN_NULL != err)
	{
		return (err);
	}
	
	//上位机写操作
	if(OPE_WRITE == mon->CanMess.CMDPara)
	{
	}
	
	
	return (ret);
}

/*
 * @function: MonRead208Reply
 * @details : 应答上位机读新增气压探测液面参数。
 * @input   : 1.mon：管理指针。
              2.buff：缓存。
 * @output  : NULL
 * @return  : 应答状态。
 */
uint8_t MonRead208Reply(struct tagMonCan *mon, uint8_t *buff)
{
	uint8_t    ret = CAN_OPE_REPLY;
	
	
	return(ret);
}


/*
 * @function: MonCapLLDPara3
 * @details : 上位机读写电容探测参数
 * @input   : 1.mon：监控管理指针。
              2.err：故障信息。
 * @output  : NULL
 * @return  : 0：成功；其他：故障指令。
 */
uint8_t MonCapLLDPara3(struct tagMonCan *mon, uint8_t err)
{
	uint8_t    ret = 0;
	
	
	//故障指令或操作码，不进行任何操作
	if(ERR_CAN_NULL != err)
	{
		return (err);
	}
	
	//上位机写操作
	if(OPE_WRITE == mon->CanMess.CMDPara)
	{	
		WriteCLLDPara3(mon->RxMsg.Data, 0);
	}
	
	
	return (ret);
}

/*
 * @function: MonCapLLDPara3Reply
 * @details : 应答上位机设置电容探测液面参数。
 * @input   : 1.mon：管理指针。
              2.buff：缓存。
 * @output  : NULL
 * @return  : 应答状态。
 */
uint8_t MonCapLLDPara3Reply(struct tagMonCan *mon, uint8_t *buff)
{
	uint8_t    ret = CAN_OPE_REPLY;
	
	
	//阻塞应答
//	if(CP_COMM_NORMAL != CapSenPara.ResStatu)
//	{
//		return (CAN_OPE_WAIT);
//	}
	
	ReadCLLDPara3(buff, 0);
	
	
	return(ret);
}


/*
 * @function: MonReadCapVal
 * @details : 上位读电容映射数据
 * @input   : 1.mon：监控管理指针。
              2.err：故障信息。
 * @output  : NULL
 * @return  : 0：成功；其他：故障指令。
 */
uint8_t MonReadCapVal(struct tagMonCan *mon, uint8_t err)
{
	uint8_t    ret = 0;
	
	
	//故障指令或操作码，不进行任何操作
	if(ERR_CAN_NULL != err)
	{
		return (err);
	}
	
	//上位机写操作
	if(OPE_WRITE == mon->CanMess.CMDPara)
	{
		WriteCapMapVal(mon->RxMsg.Data, 0);
	}
	
	
	return (ret);
}

/*
 * @function: MonReadCapValReply
 * @details : 应答上位机读取电容值。
 * @input   : 1.mon：管理指针。
              2.buff：缓存。
 * @output  : NULL
 * @return  : 应答状态。
 */
uint8_t MonReadCapValReply(struct tagMonCan *mon, uint8_t *buff)
{
	uint8_t    ret = CAN_OPE_REPLY;
	
	
	ReadCapMapVal(buff, 0);
	
	
	return(ret);
}


/*
 * @function: MonAirLLDPara1
 * @details : 上位机设置气压探测参数1
 * @input   : 1.mon：监控管理指针。
              2.err：故障信息。
 * @output  : NULL
 * @return  : 0：成功；其他：故障指令。
 */
uint8_t MonAirLLDPara1(struct tagMonCan *mon, uint8_t err)
{
	uint8_t    ret = 0;
	
	
	//故障指令或操作码，不进行任何操作
	if(ERR_CAN_NULL != err)
	{
		return (err);
	}
	
	//上位机写操作
	if(OPE_WRITE == mon->CanMess.CMDPara)
	{	
		WriteAirLLDPara1(mon->RxMsg.Data, mon->CanMess.DevNo);
	}
	
	
	return (ret);
}

/*
 * @function: MonAirLLDPara1Reply
 * @details : 上位机设置气压探测参数1应答
 * @input   : 1.mon：管理指针。
              2.buff：缓存。
 * @output  : NULL
 * @return  : 应答状态。
 */
uint8_t MonAirLLDPara1Reply(struct tagMonCan *mon, uint8_t *buff)
{
	uint8_t    ret = CAN_OPE_REPLY;
	
	
	ReadAirLLDPara1(buff, mon->CanMess.DevNo);
	
	
	return(ret);
}


/*
 * @function: MonAirLLDPara2
 * @details : 上位机设置气压探测参数2
 * @input   : 1.mon：监控管理指针。
              2.err：故障信息。
 * @output  : NULL
 * @return  : 0：成功；其他：故障指令。
 */
uint8_t MonAirLLDPara2(struct tagMonCan *mon, uint8_t err)
{
	uint8_t    ret = 0;
	
	
	//故障指令或操作码，不进行任何操作
	if(ERR_CAN_NULL != err)
	{
		return (err);
	}
	
	//上位机写操作
	if(OPE_WRITE == mon->CanMess.CMDPara)
	{
		WriteAirLLDPara2(mon->RxMsg.Data, 0);
	}
	
	
	return (ret);
}

/*
 * @function: MonAirLLDPara2Reply
 * @details : 上位机设置气压探测参数2应答
 * @input   : 1.mon：管理指针。
              2.buff：缓存。
 * @output  : NULL
 * @return  : 应答状态。
 */
uint8_t MonAirLLDPara2Reply(struct tagMonCan *mon, uint8_t *buff)
{
	uint8_t    ret = CAN_OPE_REPLY;
	
	
	ReadAirLLDPara2(buff, 0);
	
	
	return(ret);
}


/*
 * @function: MonAirLLDPara3
 * @details : 上位机设置气压探测参数
 * @input   : 1.mon：监控管理指针。
              2.err：故障信息。
 * @output  : NULL
 * @return  : 0：成功；其他：故障指令。
 */
uint8_t MonAirLLDPara3(struct tagMonCan *mon, uint8_t err)
{
	uint8_t    ret = 0;
	
	
	//故障指令或操作码，不进行任何操作
	if(ERR_CAN_NULL != err)
	{
		return (err);
	}
	
	//上位机写操作
	if(OPE_WRITE == mon->CanMess.CMDPara)
	{
		WriteAirLLDPara3(mon->RxMsg.Data, 0);
	}
	
	
	return (ret);
}

/*
 * @function: MonAirLLDPara3Reply
 * @details : 应答上位机读取气压探测参数。
 * @input   : 1.mon：管理指针。
              2.buff：缓存。
 * @output  : NULL
 * @return  : 应答状态。
 */
uint8_t MonAirLLDPara3Reply(struct tagMonCan *mon, uint8_t *buff)
{
	uint8_t    ret = CAN_OPE_REPLY;
	
	
	ReadAirLLDPara3(buff, 0);
	
	
	return(ret);
}


/*
 * @function: MonReadAirVal
 * @details : 上位读气压映射数据
 * @input   : 1.mon：监控管理指针。
              2.err：故障信息。
 * @output  : NULL
 * @return  : 0：成功；其他：故障指令。
 */
uint8_t MonReadAirVal(struct tagMonCan *mon, uint8_t err)
{
	uint8_t    ret = 0;
	
	
	//故障指令或操作码，不进行任何操作
	if(ERR_CAN_NULL != err)
	{
		return (err);
	}
	
	//上位机写操作
	if(OPE_WRITE == mon->CanMess.CMDPara)
	{
		WriteAirMapVal(mon->RxMsg.Data, 0);
	}
	
	
	return (ret);
}

/*
 * @function: MonReadAirValReply
 * @details : 应答上位机读取气压值。
 * @input   : 1.mon：管理指针。
              2.buff：缓存。
 * @output  : NULL
 * @return  : 应答状态。
 */
uint8_t MonReadAirValReply(struct tagMonCan *mon, uint8_t *buff)
{
	uint8_t    ret = CAN_OPE_REPLY;
	
	
	ReadAirMapVal(buff, 0);
	
	
	return(ret);
}




/*
 * @function: MonReadSoftWareName
 * @details : 监控读软件名称
 * @input   : 1.mon：监控管理指针。
              2.err：故障信息。
 * @output  : NULL
 * @return  : 0：成功；其他：故障指令。
 */
uint8_t MonReadSoftWareName(struct tagMonCan *mon, uint8_t err)
{
	uint8_t    ret = 0;
	
	
	//故障指令或操作码，不进行任何操作
	if(ERR_CAN_NULL != err)
	{
		return (err);
	}
	
	
	//上位机写操作
	if(OPE_WRITE == mon->CanMess.CMDPara)
	{
	}
	
	
	//上位机读操作
	if(OPE_READ == mon->CanMess.CMDPara)
	{
//		ReadSoftWareNameIns(mon->RxMsg.Data, 0);
	}
	
	
	return (ret);
}

/*
 * @function: MonReadSoftWareNameReply
 * @details : 应答读软件名称。
 * @input   : 1.mon：管理指针。
              2.buff：缓存。
 * @output  : NULL
 * @return  : 应答状态。
 */
uint8_t MonReadSoftWareNameReply(struct tagMonCan *mon, uint8_t *buff)
{
	uint8_t    ret = CAN_OPE_REPLY;
	
	
//	ReadSoftWareName(buff, 0);
	
	
	return(ret);
}


/*
 * @function: MonReadSoftWareVer
 * @details : 监控读软件版本
 * @input   : 1.mon：监控管理指针。
              2.err：故障信息。
 * @output  : NULL
 * @return  : 0：成功；其他：故障指令。
 */
uint8_t MonReadSoftWareVer(struct tagMonCan *mon, uint8_t err)
{
	uint8_t    ret = 0;
	
	
	//故障指令或操作码，不进行任何操作
	if(ERR_CAN_NULL != err)
	{
		return (err);
	}
	
	
	//上位机写操作
	if(OPE_WRITE == mon->CanMess.CMDPara)
	{
	}
	
	
	return (ret);
}

/*
 * @function: MonReadSoftWareVerReply
 * @details : 应答读软件版本。
 * @input   : 1.mon：管理指针。
              2.buff：缓存。
 * @output  : NULL
 * @return  : 应答状态。
 */
uint8_t MonReadSoftWareVerReply(struct tagMonCan *mon, uint8_t *buff)
{
	uint8_t    ret = CAN_OPE_REPLY;
	
	
	ReadSoftWareVer(buff, 0);
	
	
	return(ret);
}
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
