cradle08/LLD_TMC/(commit log)

2023-01-07 first commit, lanch test project
    [MiniSTM32 V3 IO引脚分配表.xlsx]
2023-01-10 add lld project and doc, modify function
    [MiniSTM32 V3 IO引脚分配表.xlsx]
2023-01-11 modify uart. and add tmc2009 files
2023-01-14 step dir fucntion is ok, motor is move
2023-01-17 uart function is ok
2023-02-06 modify lld param add write error bug
    [app.c, eeprom.c, eeprom.h, monitor_can.c]
2023-02-10 add sys queue but not use it -- test error
    [CanID_Config.txt]
2023-02-10 add USE_OS_QUEUE flag to switch
2023-02-13 modify LED SYS and so on
2023-02-15 open mco via pa8 and msg handle for motor
2023-04-25 modify LED
2023-05-09 update v1.0.4 motor code to lld-tmc
2023-06-01 update v1.0.5 motor code to lld
2023-06-16 change name to LLD002_TMC5130A, and update lasetest motor code
    [CanID_Config.txt]
2023-06-25 update the lastest lld code and motor
